rtcw50/watch_cleaner_controller/(list of files, cad)

Other CAD files:
LongBracket2.f3d
