rtcw50/watch_cleaner_controller/Schematic_TouchScreenMotorController_2025-12-24.pdf

LM2596

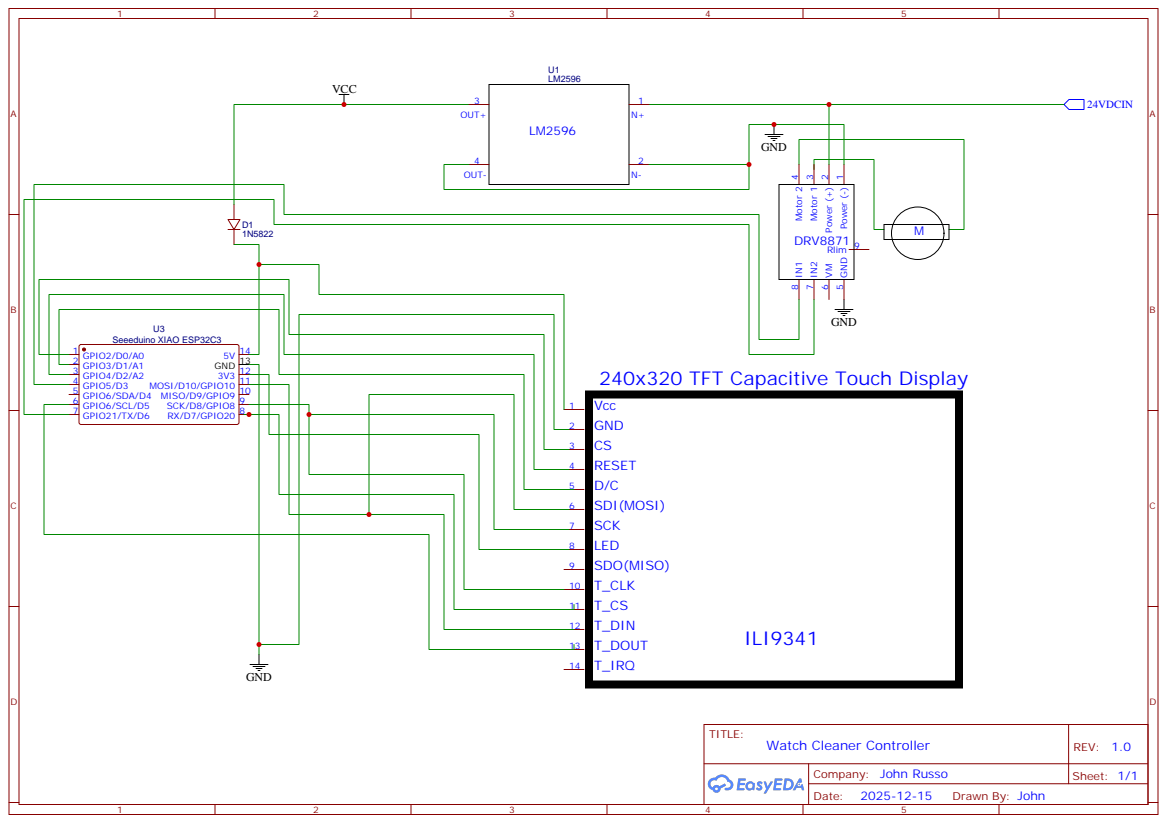
[picture p1: page 1]

240x320 TFT Capacitive Touch Display
