rtcw50/watch_cleaner_controller/(list of files, drawings)

Other design files:
SCH_TouchScreenMotorController_2025-12-24.json
