rtcw50/watch_cleaner_controller/wcc_motor_controller.cpp

/*
 * File: wcc_motor_controller.cpp
 * Author: John
 * Date: 2025-11-23
 * Description:
 *   Motor control and logic 
 *   Motor ramping is done in chunks via a timer callback to avoid long
 *      duration ramping in a for loop. Long duration function make the UI 
 *      unresponsive b/c the timer handler is not called often enough.
 */
#include <Arduino.h>
#include <lvgl.h>
#include "wcc_common.h"

/* Defines */

/* Externs */
extern lv_subject_t max_rpm_int_subject;
extern lv_subject_t spin_up_rate_int_subject;
extern enum class OperatingState g_operating_state;

/* Statics */
static uint8_t in1;
static uint8_t in2;
static lv_timer_t * ramp_up_timer;
static lv_timer_t * ramp_down_timer;

/* Local typedefs */
typedef struct ramp_user_data {
    int32_t rpm_tracker;
    wcc_cb_t on_done;
} ramp_user_data;

static void invert_in_pins()
{
    uint8_t tmp;
    tmp = in1;
    in1 = in2;
    in2 = tmp;
}

static void ramp_up_internal_cb(lv_timer_t * motor_timer)
{
    ramp_user_data * tracker_data = (ramp_user_data *)lv_timer_get_user_data(motor_timer);
    extern pwm_info pwm_values;
    LV_LOG_USER("...called");

    // Invoking the reverse function ramps down and then up (in opposite direction)
    // So it is possible to have two ramp timers going concurrently.
    // But it makes no sense for one timer cb to ramp down and the other to ramp up
    // So do nothing if until the other timer is finished.
    if (g_operating_state != OperatingState::stopped) {
        LV_LOG_USER("... returned");
        return;
    }

    analogWrite(in2, tracker_data->rpm_tracker);

    tracker_data->rpm_tracker += pwm_values.pwm_increment; 

    if (tracker_data->rpm_tracker > pwm_values.pwm_rpm) {
        // done ramping up 
        lv_timer_delete(motor_timer); // Alias for ramp_up_timer
        ramp_up_timer = NULL;  // Nullify reference to motor timer
        if (tracker_data->on_done != NULL) {
            tracker_data->on_done();
        }
        // Set driving pin to final pulse width 
        analogWrite(in2, pwm_values.pwm_rpm);
        g_operating_state = OperatingState::running;
        LV_LOG_USER("... complete: in1=%d, in2=%d", in1, in2);
        
    }
}

static void ramp_down_internal_cb(lv_timer_t * motor_timer)
{
    ramp_user_data * tracker_data = (ramp_user_data *)lv_timer_get_user_data(motor_timer);
    extern pwm_info pwm_values;

    // Invoking the reverse function ramps down and then up (in opposite direction)
    // So it is possible to have two ramp timers going concurrently.
    // But it makes no sense for one timer cb to ramp down and the other to ramp up
    // So do nothing if until the other timer is finished.
    if (g_operating_state != OperatingState::running) {
        LV_LOG_USER("... returned");
        return;
    }

    analogWrite(in2, tracker_data->rpm_tracker);

    tracker_data->rpm_tracker -= pwm_values.pwm_increment; 

    if (tracker_data->rpm_tracker < 0) {
        // Complete the ramp down 
        // Set driving pin to a static value
        LV_ASSERT(ledcDetach(in2) == true); // Stop PWM on pin
        pinMode(in2,OUTPUT);
        digitalWrite(in2, LOW); 

        lv_timer_delete(motor_timer); // Alias for ramp_down_timer
        ramp_down_timer = NULL; // Nullify reference to motor timer
        if (tracker_data->on_done != NULL) {
            tracker_data->on_done(); // reverse inputs 
        }
        g_operating_state = OperatingState::stopped;
        LV_LOG_USER("... complete: in1=%d, in2=%d", in1, in2);
    }
}

static void ramp_motor_up(lv_timer_cb_t ramp_cb, wcc_cb_t action_on_done)
{
    // Starting value for the tracking variable 
    static ramp_user_data tracker_data;
    tracker_data.rpm_tracker = 10; // Start from low rpm, not zero to avoid single pulse issue 
    tracker_data.on_done = action_on_done;
    
    // Write one input to static level 
    digitalWrite(in1,LOW);

    if (ramp_up_timer == NULL) {
        LV_LOG_USER("ramp_up_timer created");
        ramp_up_timer = lv_timer_create(ramp_cb, RAMP_UPDATE_MS, &tracker_data);
    }
}

static void ramp_motor_down(lv_timer_cb_t ramp_cb, wcc_cb_t action_on_done)
{
    extern pwm_info pwm_values;
    // Starting value for the tracking variable 
    static ramp_user_data tracker_data; 
    tracker_data.rpm_tracker = pwm_values.pwm_rpm;
    tracker_data.on_done = action_on_done;
    
    // Write one input to static level 
    digitalWrite(in1, LOW);

    if (ramp_down_timer == NULL) {
        LV_LOG_USER("ramp_down_timer created");
        ramp_down_timer = lv_timer_create(ramp_cb, RAMP_UPDATE_MS, &tracker_data);
    }
}

void wcc_drv8871_ramp_up(boolean invert_driver_pins)
{
    LV_LOG_USER("... called");
    if (ramp_up_timer != NULL) {
        lv_timer_delete(ramp_up_timer);
        ramp_up_timer = NULL;
    }
    if (invert_driver_pins) {
        ramp_motor_up(ramp_up_internal_cb, invert_in_pins);
    }   
    else {
        ramp_motor_up(ramp_up_internal_cb, NULL);
    }    

}

void wcc_drv8871_ramp_down(boolean invert_driver_pins)
{
    LV_LOG_USER("... called");
    if (ramp_down_timer != NULL) {
        lv_timer_delete(ramp_down_timer);
        ramp_down_timer = NULL;
    }   
    if (invert_driver_pins) {
        ramp_motor_down(ramp_down_internal_cb, invert_in_pins);
    }
    else {
        ramp_motor_down(ramp_down_internal_cb, NULL);
    }
}
void wcc_drv8871_ramp_down_final()
{
    // Kill any ongoing ramp up first
    // Note if an active ramp down is in progress, we let it complete as this ramp down will be no-op
    if (ramp_up_timer != NULL) {
        lv_timer_delete(ramp_up_timer);
        ramp_up_timer = NULL;
    }
    if (ramp_down_timer != NULL) {
        lv_timer_delete(ramp_down_timer);
        ramp_down_timer = NULL;
    }
    LV_LOG_USER("... called");
    // This is an abrupt stop, but the alternative is to call ramp_motor_down,
    // which sets the rpm to the set value and then ramp down
    ledcDetach(in2); // Stop PWM on pin
    pinMode(in2,OUTPUT);
    digitalWrite(in2, LOW); 
    g_operating_state = OperatingState::stopped;
}

void wcc_drv8871_reverse()
{
    // Reverse may be called before a ramp up or down is finished.
    if (g_operating_state == OperatingState::running) {
        wcc_drv8871_ramp_down(true /*invert inputs after ramp down*/);
        wcc_drv8871_ramp_up(false);
    }
    else {
        wcc_drv8871_ramp_up(true /* invert inputs */);
    }
}

void wcc_drv8871_init_in_pins(uint8_t p1, uint8_t p2)
{
    in1 = p1;
    in2 = p2;
    pinMode(in1,OUTPUT);
    pinMode(in2,OUTPUT);
    digitalWrite(in1,LOW);
    digitalWrite(in2,LOW);
    
}
