rtcw50/watch_cleaner_controller/(commit log)

2023-10-29 Update watch_cleaner_controller.ino
    Redesign with lookup tables for the timer and motor speed.
    Now uses for loop for motor fwd/rev cycle.
    [watch_cleaner_controller.ino]
2025-10-28 Rename watch_cleaner_gui.ino to watch_cleaner_controller.ino
    Renamed main file to help Vscode Arduino project understand the project
2025-10-29 main buttons created for UI
    Simplified UI has two buttons on the main screen, a start/stop button and a clean/spin button. Both buttons are checked buttons, meaning that toggle their state when clicked. Start and stop starts and stops either the clean or spin mode. A status label is place at the bottom of the main screen.
2025-11-03 Add custom sized gear icon for settings page
    LVGL allows you to customize the pre-canned symbols available in lv_font library API. I created a 50x50 px gear icon that resided in the lower right corner of the display. The plan is to invoke a settings screen to set various speed and duration parameters on that screen. I also created a HOME icon and the BACK icon for future use.
2025-11-07 count down timer on main button working now
    The start button creates the main timer. The main timer repeats a user defined number of times. The timer is set to expire once per second. The mode of the main button become the stop button and clicking it stops and deletes the timer.
2025-11-08 play, pause, stop buttons implemented
    Motor control is initiated with the play and pause buttons. The stop button stops the activity if motor is running or paused.
    Removed custom symbol fonts, using the built in 48px symbol font now.
2025-11-12 Add clean,rinse,spin radio buttons
    The clean rinse spin radio buttons set the operating mode of the machine. Each will have its own properties, such as duration set on the settings page.
2025-11-14 Created new screen for settings
    The settings button on the main screen loads the settings screen. The settings screen has a return button to return to the main screen. The settings screen is where the various parameters will set set.
2025-11-15 Add additional settings
    Limited space for return button, come back to this
2025-11-17 More interface refinements
    Make settings done button and place in settings title bar. Colored and re-oriented the run/pause and stop buttons. Added a wcc_common.h file for common definitions.
2025-11-19 Correct Mode Selector
    Correct the Mode Selector operation since the child index of the checkbox changed due to addition of header label in the radio button container.
    [wcc_main_screen.cpp, wcc_styles.cpp]
2025-11-19 Establish data bindings to settings variables
    Used the subject observer pattern to bind the settings labels to an int variable. Updated with up/down buttons. Only clean duration/up button implemented for this checkin.
    [watch_cleaner_controller.ino, wcc_common.h, wcc_settings.cpp]
2025-11-21 settings panel completed
    The settings panel is completed. The up/down button increment/decrement on a SHORT_CLICK event by an amount appropriate for the field. The info in the label is bound to a data value via subject/observer pattern.
    [watch_cleaner_controller.ino, wcc_settings.cpp]
2025-11-21 timer durations now determined by the operating mode
    The timer duration shown on the main status screen is now determined by the operating mode selected and the duration set in the settings panel.
2025-11-28 motor pulses ramp up and down basically working
    Discovered pin D4 on my test chip is inoperable. Changed to D3,D6 to drive motor. Basic ramp up and down and reverse of motor is working. Still need to drive non pwm to static level on motor reverse.
    [watch_cleaner_controller.ino, wcc_common.h, wcc_main_screen.cpp, wcc_motor_controller.cpp, wcc_settings.cpp]
2025-12-01 Correct ramp up down waveforms now
    Still have a spurious pulse prior to ramp up sequence to be debugged
    [watch_cleaner_controller.ino, wcc_motor_controller.cpp]
2025-12-01 Fine tuning ramp state machine
    Overall is working ok. There is a problem when pause then resume is pressed quickly near the main timer expiry. You end up with this sequence:
    Start button (pause to play icon): not checked
    ramp down from pause button
    Start button: (run-pause to pause icon ) checked
    ramp up event value changed
    clean_rinse timer callback
    clean_rinse timer callback
    final ramp down from timer
    ramp_down_complete: in1=5, in2=21
    ramp_up_complete: in1=5, in2=21
    which is a ramp up event happening after the main timer expiry. This ends up with the motor running even though the timer expired.
    [wcc_main_screen.cpp, wcc_motor_controller.cpp, wcc_settings.cpp]
2025-12-02 Fully functional now
    Stop and pause buttons do an abrupt stop instead of ramping down. Resume ramps up. Refactored the start button code for readability.
2025-12-03 Fix spin mode action
    Do not agitate in spin mode. Run full RPM in spin mode.
    [wcc_main_screen.cpp, wcc_settings.cpp]
2025-12-04 Proper LVGL logging implemented
    Manual Serial.println statements were replaced with LV_LOG_USER macro statements. Logging will be disable for the production release in lv_conf.h by LV_USE_LOG 0. Otherwise for testing and debugging LV_USE_LOG 1 and LV_LOG_LEVEL to LV_LOG_LEVEL_WARN which will print WARN, ERROR and USER messages to Serial output. A few other clean ups of unused code.
    [watch_cleaner_controller.ino, wcc_main_screen.cpp, wcc_motor_controller.cpp, wcc_settings.cpp]
2025-12-24 Added schematics
    Circuit schematics added. PDF and EasyEDA project file.
    [SCH_TouchScreenMotorController_2025-12-24.json]
2025-12-24 Save LongBracket2 fusion360 3d parts project file
    This is the project file for most of the 3D printed components for the watch cleaner. The box holding the display and circuit board were purchased separately from Amazon. The project box dimensions were 88x112x54 (HWD) mm. Any similar project box will work.
    [LongBracket2.f3d]
